lhr-solar/Controls-LightingPCB/README.md

# Controls-LightingPCB

Purpose: This board controls all lightings effects activated by driver controls on the inside and outside of the car.

Dimensions: 73.9140 mm by 98.8060 mm

BOM: Located under Controls-LightingPCB\BOM
