lhr-solar/Controls-LightingPCB/(threads)

Thread 6 (2021-11-02):

Change isoSPI -> SPI

HannahSLee14, 2021-11-02:
Since isoSPI is giving us a lot of issues, we are going to remove the chips associated with isoSPI (LTC6820 and HX1188FNL) and any components that are a part of its circuitry. We are going to send out the SPI signals instead (MISO, MOSI, CLK, CS).

** We should check the number of wires we can have in the steering wheel disconnect. **

Closed 2025-09-18.

Thread 7 (2021-11-20):

Remove Rearview Display Connector

JimothyGreene, 2021-11-20:
We're no longer routing 12V/GNDPWR through this board, so we can remove that connector

Closed 2025-09-18.

Thread 10 (2022-05-11):

Route the BPS fault ground trace to the BPS power LED as well.

babusid, 2022-05-11:
The BPS Power LED is currently hooked up to the wrong ground (ie. common ground plane), when it is not receiving the common 5v voltage that the rest of the LED use. It is receiving the 12v from the leaderboard which corresponds to the BPS Fault LED Ground.

Closed 2025-09-18.

Thread 12 (2023-02-25):

Missing gate pulldown resistor

tiandahuang, 2023-02-25:
missing gate pulldown resistor brakelight

Closed 2023-08-23.
