lhr-solar/Controls-LightingPCB/hardware/Controls-LightingRev2PCB.kicad_pcb

## KiCad design hardware/Controls-LightingRev2PCB.kicad_pcb (2026-03-15)

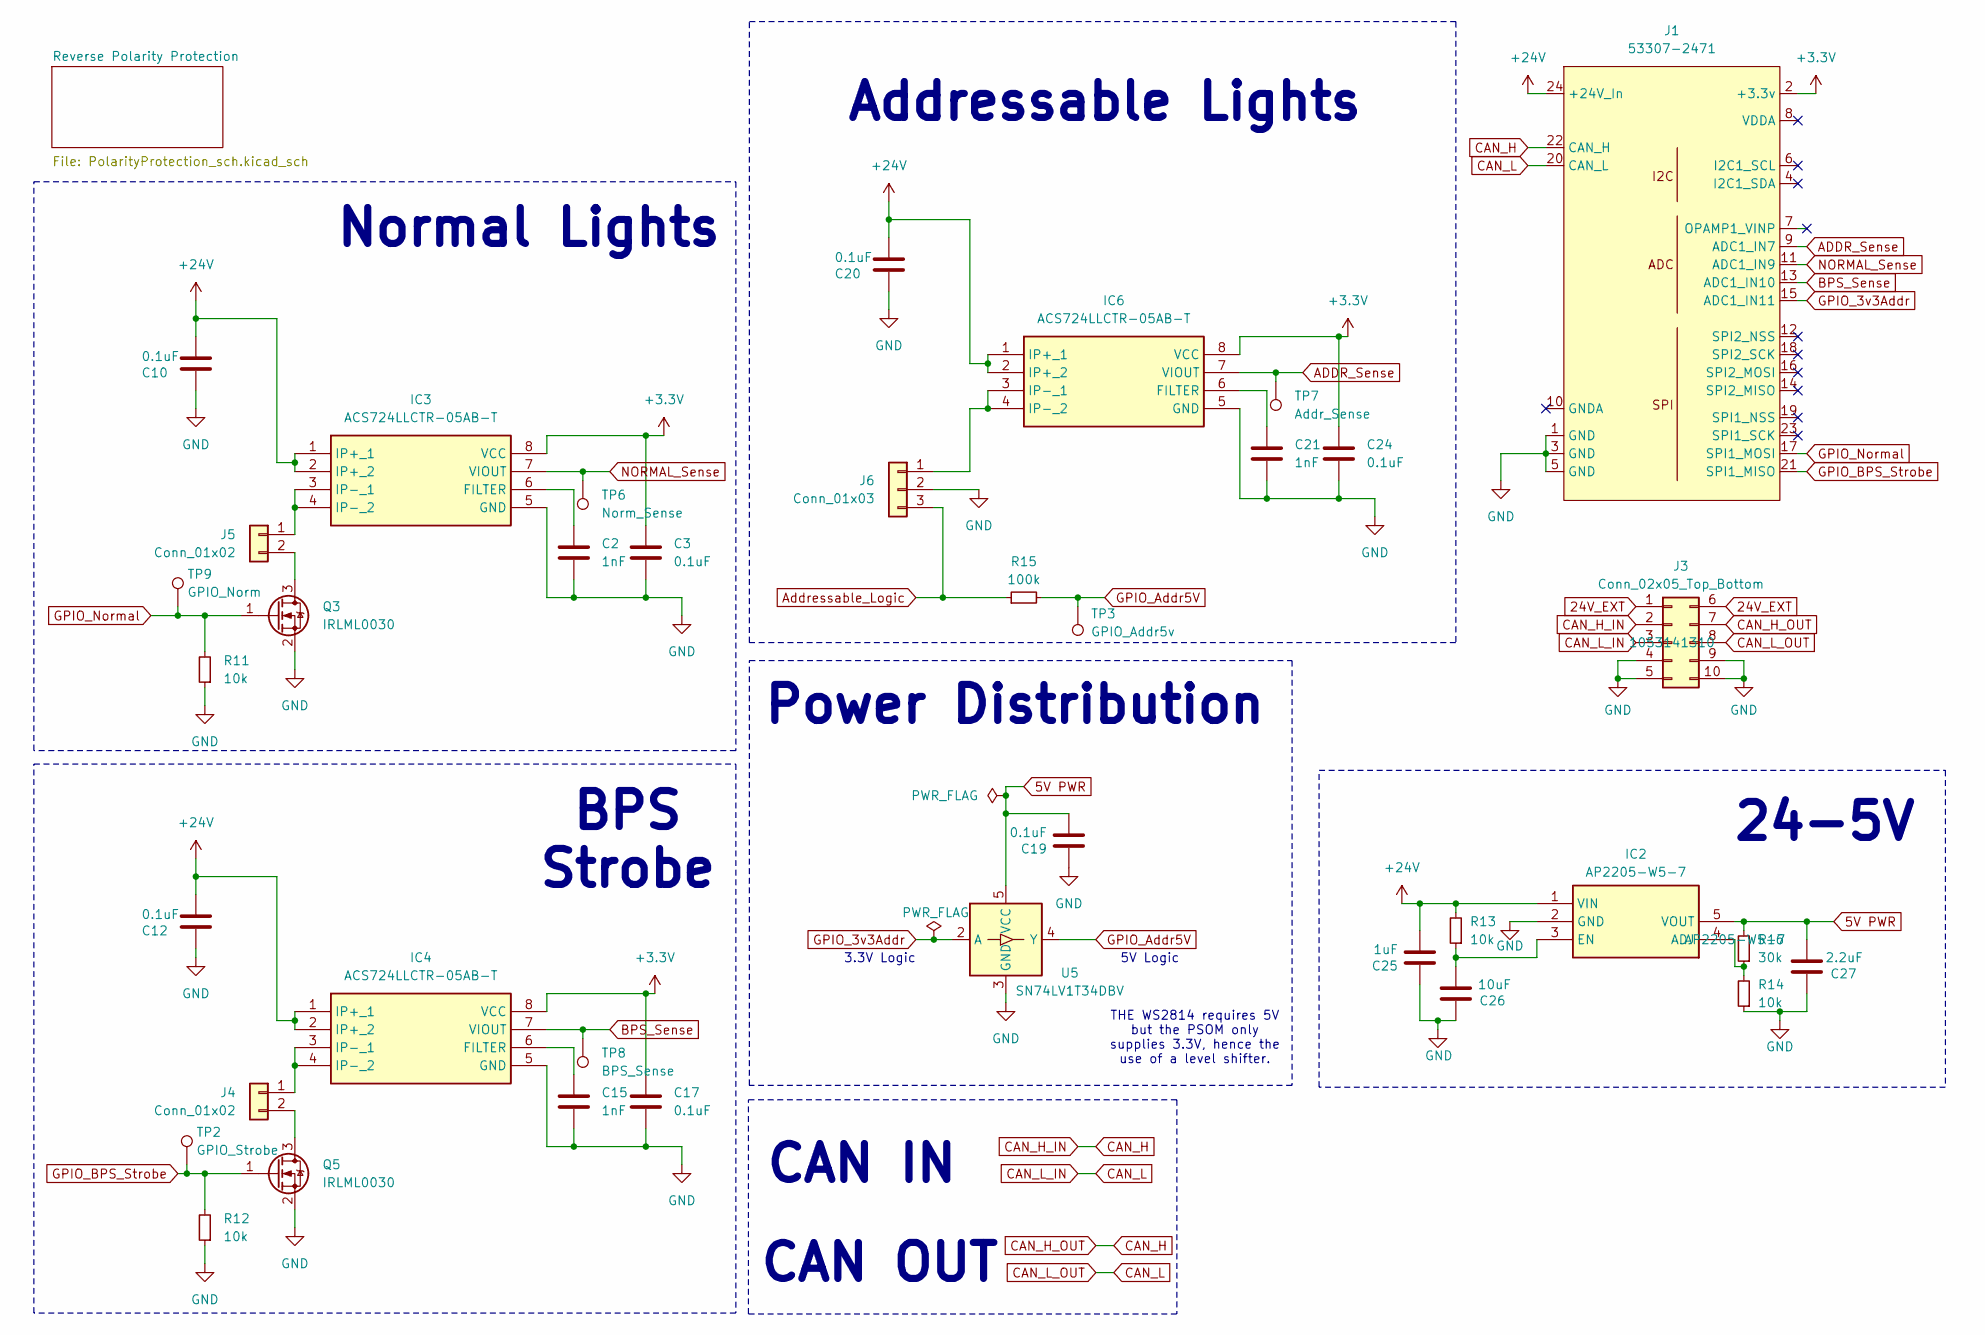
[picture p1: schematic Controls-LightingRev2PCB.kicad_sch]

Parts:
C2, C15, C21: 1nF; C_0603_1608Metric; LCSC P/N C1588
C3, C10, C12, C17, C19, C20, C24: 0.1uF; C_0603_1608Metric; LCSC P/N C14663
C25: 1uF; C_0603_1608Metric; LCSC P/N C15849
C26: 10uF; C_0805_2012Metric_Pad1.18x1.45mm_HandSolder; LCSC P/N C440198
C27: 2.2uF; C_0603_1608Metric; LCSC P/N C57895
IC2: AP2205-W5-7; AP2205W57; Mouser Part Number 621-AP2205-W5-7
IC3: ACS724LLCTR-05AB-T; SOIC127P600X175-8N; LCSC P/N C22392329
IC4: ACS724LLCTR-05AB-T; SOIC127P600X175-8N; Manufacturer_Part_Number ACS724LLCTR-05AB-T; LCSC P/N C22392329
IC6: ACS724LLCTR-05AB-T; SOIC127P600X175-8N; Mouser Part Number ACS724LLCTR-05AB-T
J1: 53307-2471; PeripheralSOM
J3: Conn_02x05_Top_Bottom; Molex_Nano-Fit_105314-xx10_2x05_P2.50mm_Horizontal
J4, J5: Conn_01x02; 105313-2102
J6: Conn_01x03; 105313-1103
Q3, Q5: IRLML0030; SOT-23; LCSC P/N C67272
R11, R12, R13, R14: 10k; R_0603_1608Metric; LCSC P/N C25804
R15: 100k; R_0603_1608Metric; LCSC P/N C25803
R16: 30k; R_0603_1608Metric; LCSC P/N C18681
TP2: GPIO_Strobe; TestPoint_Keystone_5005-5009_Compact
TP3: GPIO_Addr5v; TestPoint_Keystone_5005-5009_Compact
TP6: Norm_Sense; TestPoint_Keystone_5005-5009_Compact
TP7: Addr_Sense; TestPoint_Keystone_5005-5009_Compact
TP8: BPS_Sense; TestPoint_Keystone_5005-5009_Compact
TP9: GPIO_Norm; TestPoint_Keystone_5005-5009_Compact
U5: SN74LV1T34DBV; SOT-23-5; LCSC P/N C47117565

Connections:
5V PWR: C19.2, C27.2, IC2.5 (VOUT), R16.2, U5.5 (VCC)
24V_EXT: J3.1, J3.6; also elsewhere on the board
+3.3V: C3.1, C17.1, C24.1, IC3.8 (VCC), IC4.8 (VCC), IC6.8 (VCC), J1.2 (+3.3v)
+24V: C10.2, C12.2, C20.2, C25.2, IC2.1 (VIN), IC3.1 (IP+_1), IC3.2 (IP+_2), IC4.1 (IP+_1), IC4.2 (IP+_2), IC6.1 (IP+_1), IC6.2 (IP+_2), J1.24 (+24V_In), R13.2; also elsewhere on the board
ADDR_Sense: IC6.7 (VIOUT), J1.9 (ADC1_IN7), TP7.1
Addressable_Logic: J6.3, R15.1
BPS_Sense: IC4.7 (VIOUT), J1.13 (ADC1_IN10), TP8.1
CAN_H: J1.22 (CAN_H), J3.2, J3.7
CAN_L: J1.20 (CAN_L), J3.3, J3.8
GND: C2.2, C3.2, C10.1, C12.1, C15.2, C17.2, C19.1, C20.1, C21.2, C24.2, C25.1, C26.1, C27.1, IC2.2 (GND), IC3.5 (GND), IC4.5 (GND), IC6.5 (GND), J1.1 (GND), J1.3 (GND), J1.5 (GND), J3.4, J3.5, J3.9, J3.10, J6.2, Q3.2 (S), Q5.2 (S), R11.1, R12.1, R14.1, U5.3 (GND); also elsewhere on the board
GPIO_3v3Addr: J1.15 (ADC1_IN11), U5.2 (A)
GPIO_Addr5V: R15.2, TP3.1, U5.4 (Y)
GPIO_BPS_Strobe: J1.21 (SPI1_MISO), Q5.1 (G), R12.2, TP2.1
GPIO_Normal: J1.17 (SPI1_MOSI), Q3.1 (G), R11.2, TP9.1
NORMAL_Sense: IC3.7 (VIOUT), J1.11 (ADC1_IN9), TP6.1
unnamed: IC2.4 (ADJ), R14.2, R16.1
unnamed: C26.2, IC2.3 (EN), R13.1
unnamed: C2.1, IC3.6 (FILTER)
unnamed: IC3.3 (IP-_1), IC3.4 (IP-_2), J5.1
unnamed: C15.1, IC4.6 (FILTER)
unnamed: IC4.3 (IP-_1), IC4.4 (IP-_2), J4.1
unnamed: C21.1, IC6.6 (FILTER)
unnamed: IC6.3 (IP-_1), IC6.4 (IP-_2), J6.1
unnamed: J4.2, Q5.3 (D)
unnamed: J5.2, Q3.3 (D)

Notes on the sheet:
CAN IN
CAN OUT
THE WS2814 requires 5V but the PSOM only supplies 3.3V, hence the use of a level shifter.
24-5V
5V Logic
3.3V Logic
Normal Lights
Addressable Lights
Power Distribution
BPS Strobe

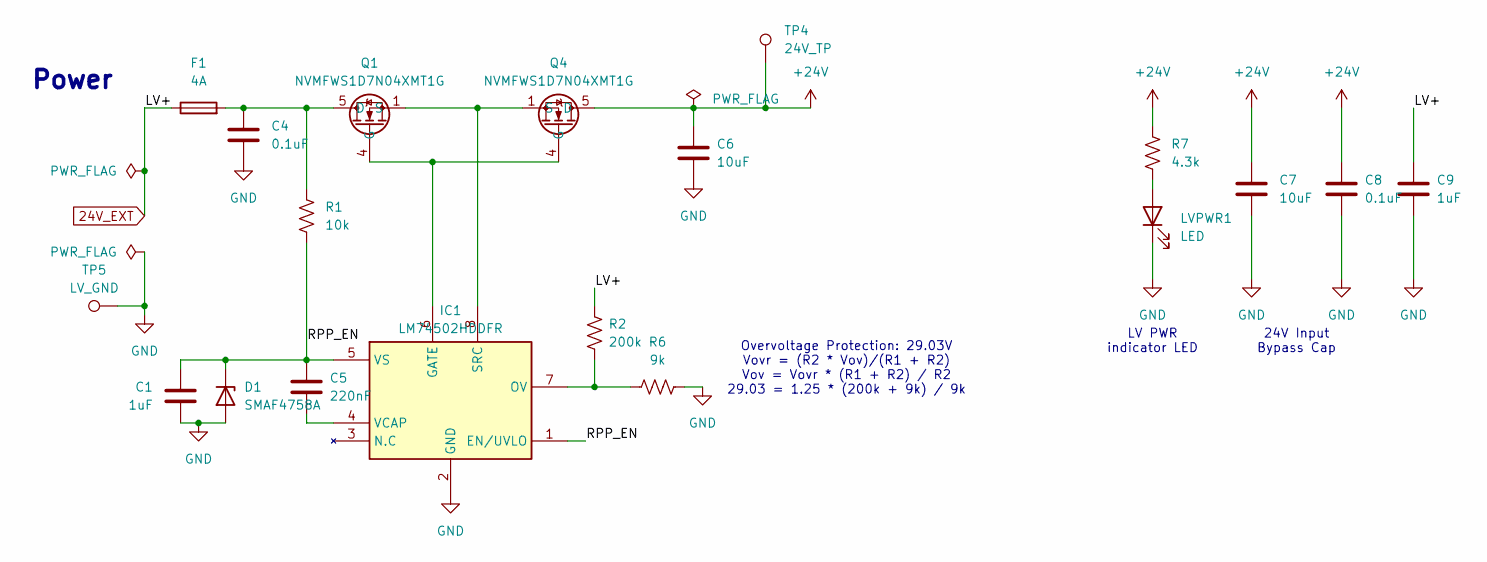
[picture p2: schematic PolarityProtection_sch.kicad_sch]

Parts:
C1: 1uF; C_0603_1608Metric; Mouser Part Number 963-UMK107BJ105KA-T
C4, C8: 0.1uF; C_0603_1608Metric; Mouser Part Number 963-HMK107B7104KA-T
C5: 220nF; C_0603_1608Metric; Mouser Part Number 963-MSASU168SB7224KT
C6, C7: 10uF; C_0805_2012Metric_Pad1.18x1.45mm_HandSolder; Mouser Part Number 81-GRM21BR61H106KE3K
C9: 1uF; C_0603_1608Metric; Mouser Part Number 963-HMK107B7104KA-T
D1: SMAF4758A; SODFL5026X125N
F1: 4A; FUSE_3568; Mouser P/N 534-3568
IC1: LM74502HDDFR; SOT65P280X110-8N; Mouser Part Number 595-LM74502HDDFR
LVPWR1: LED; LED_0603_1608Metric_Pad1.05x0.95mm_HandSolder; LCSC P/N C7371904
Q1, Q4: NVMFWS1D7N04XMT1G; NVMFWS3D0P04M8LT1G; LCSC P/N C133142
R1: 10k; R_0603_1608Metric; Mouser Part Number 71-CRCW060310K0FKEI
R2: 200k; R_0603_1608Metric; Mouser Part Number 594-MCT06030C2003FP5
R6: 9k; R_0603_1608Metric; Mouser Part Number 594-MCT06030C9091FP5
R7: 4.3k; R_0603_1608Metric; Mouser Part Number 71-CRCW0603-4.3K-E3
TP4: 24V_TP; TestPoint_Keystone_5005-5009_Compact
TP5: LV_GND; TestPoint_Keystone_5005-5009_Compact

Connections:
24V_EXT: C9.1, F1.1, R2.1; also elsewhere on the board
+24V: C6.1, C7.1, C8.1, Q4.5 (D), Q4.6 (D), Q4.7 (D), Q4.8 (D), Q4.9 (D), R7.1, TP4.1; also elsewhere on the board
/Reverse Polarity Protection/RPP_EN: C1.2, C5.1, D1.1 (K), IC1.1 (EN/UVLO), IC1.5 (VS), R1.2
GND: C1.1, C4.2, C6.2, C7.2, C8.2, C9.2, D1.2 (A), IC1.2 (GND), LVPWR1.1 (K), R6.2, TP5.1; also elsewhere on the board
unnamed: C4.1, F1.2, Q1.5 (D), Q1.6 (D), Q1.7 (D), Q1.8 (D), Q1.9 (D), R1.1
unnamed: IC1.6 (GATE), Q1.4 (G), Q4.4 (G)
unnamed: IC1.7 (OV), R2.2, R6.1
unnamed: IC1.8 (SRC), Q1.1 (S), Q1.2 (S), Q1.3 (S), Q4.1 (S), Q4.2 (S), Q4.3 (S)
unnamed: C5.2, IC1.4 (VCAP)
unnamed: LVPWR1.2 (A), R7.2

Notes on the sheet:
Overvoltage Protection: 29.03V Vovr = (R2 * Vov)/(R1 + R2) Vov = Vovr * (R1 + R2) / R2 29.03 = 1.25 * (200k + 9k) / 9k
24V Input Bypass Cap
LV PWR indicator LED
Power

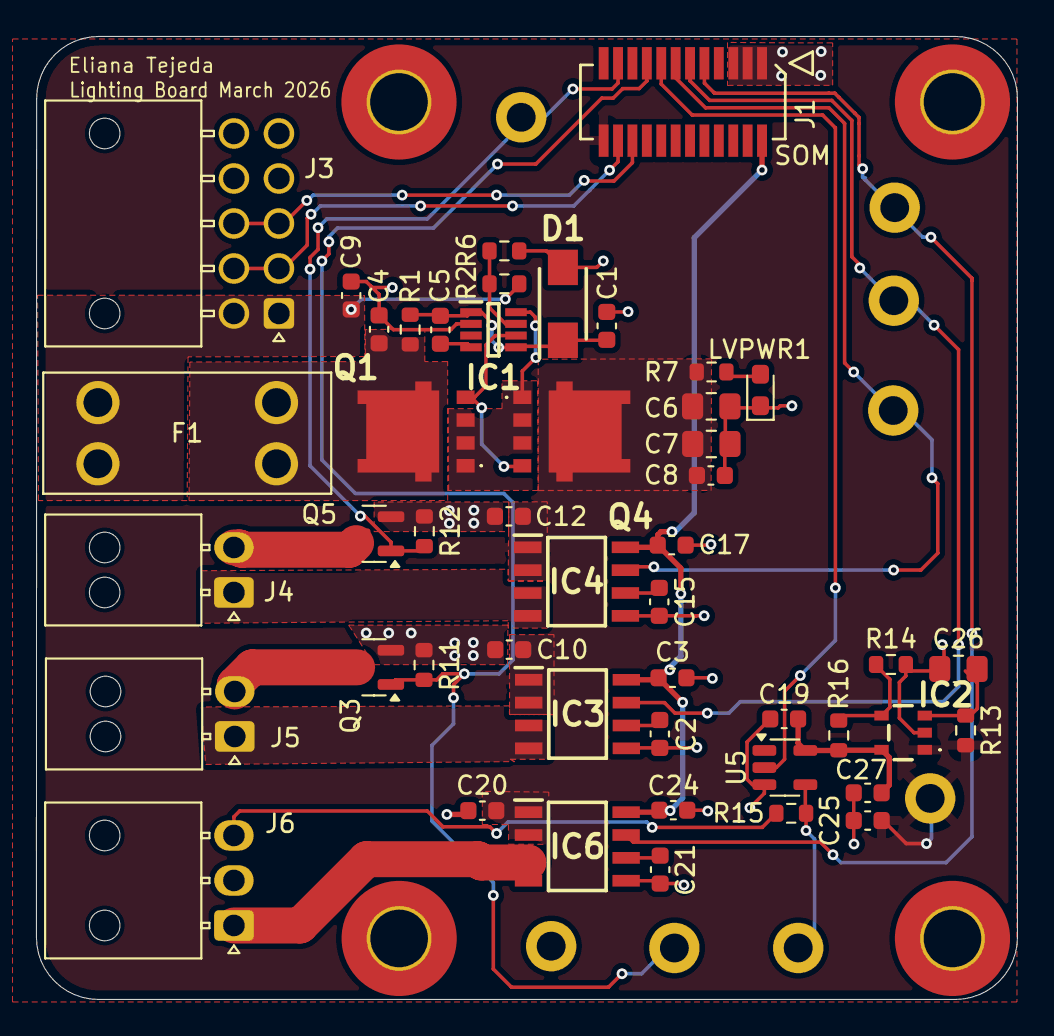
[picture p3: board Controls-LightingRev2PCB.kicad_pcb from above]

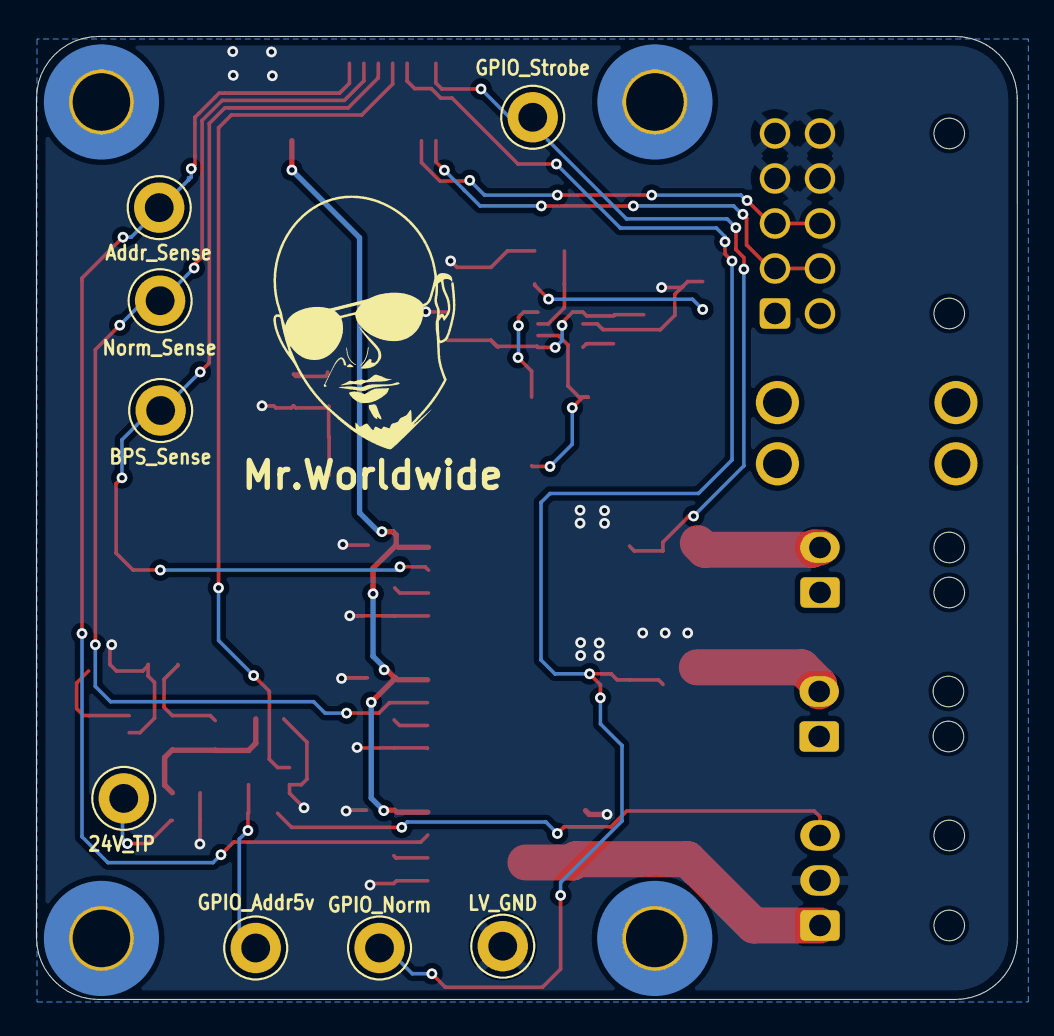
[picture p4: board Controls-LightingRev2PCB.kicad_pcb from below]

Board: 2 copper layers, 54.5 x 53.5 mm, 57 parts (9 on the bottom side), 32 nets.

Other parts of the board:
Mr.Worldwide: LOGO
