lhr-solar/Controls-LightingPCB/Firmware/LB.ioc

Mcu.UserName=STM32L431CBTx
PA0.Signal=OPAMP1_VINP
PA1.Signal=OPAMP1_VINM
PA10.Signal=USART1_RX
PA11.Signal=SPI1_MISO
PA12.Signal=SPI1_MOSI
PA2.Signal=ADCx_IN7
PA3.Signal=OPAMP1_VOUT
PA4.Signal=ADCx_IN9
PA5.Signal=ADCx_IN10
PA6.Signal=S_TIM16_CH1
PA7.Signal=GPIO_Output
PA8.Signal=GPIO_Output
PA9.Signal=USART1_TX
PB0.Signal=SPI1_NSS
PB1.Signal=ADCx_IN16
PB10.Signal=SPI2_SCK
PB11.Signal=GPIO_Output
PB12.Signal=SPI2_NSS
PB14.Signal=SPI2_MISO
PB15.Signal=SPI2_MOSI
PB6.Signal=I2C1_SCL
PB7.Signal=I2C1_SDA
PB8.Signal=CAN1_RX
PB9.Signal=CAN1_TX
