lhr-solar/Controls-LightingPCB/(commit log)

2020-09-19 Added UTSVT KiCad Libraries
2020-09-26 Started working on PCB layout
    [Controls-LightingPCB.kicad_pcb, Controls-LightingPCB.sch]
2020-09-26 Finished PCB layout
    [Controls-LightingPCB.kicad_pcb, Controls-LightingPCB.sch]
2020-10-03 Adds hierarchical sheets for control switches and switch register
    [ControlSwitches.sch, ShiftReg.sch]
2020-10-03 Creates hierarchical sheets
    [ControlSwitches.sch, Controls-LightingPCB.sch, ShiftReg.sch]
2020-10-03 Added hierarchical sheets and connections
    [ControlLEDs.sch, ControlSwitches.sch, Controls-LightingPCB.sch, ShiftReg.sch]
2020-10-03 Added HX1188FNL
    [ControlLEDs.sch, ControlSwitches.sch, Controls-LightingPCB.sch, ShiftReg.sch]
2020-10-03 Added LTC6820
    [Controls-LightingPCB.sch]
2020-10-03 Edited cap and res values
    [Controls-LightingPCB.sch]
2020-10-09 Started working on PCD design, preliminary layout of components
    [ControlLEDs.sch, ControlSwitches.sch, Controls-LightingPCB.kicad_pcb, Controls-LightingPCB.sch, ShiftReg.sch]
2020-10-10 Moves files out of individual folder and updates library paths
    [ControlLEDs.sch, ControlSwitches.sch, Controls-LightingPCB.kicad_pcb, Controls-LightingPCB.sch, ShiftReg.sch]
2020-10-10 Added changes to PCB Design
    [Controls-LightingPCB.kicad_pcb]
2020-10-10 Updated board component labels
    [Controls-LightingPCB.kicad_pcb]
2020-10-17 Switched LEDs to back side and changed dimensions of board
    [Controls-LightingPCB.kicad_pcb, Controls-LightingPCB.sch]
2020-10-17 Tried to start layout of the back side
    [Controls-LightingPCB.kicad_pcb]
2020-10-17 Made connections on back of the board
    [Controls-LightingPCB.kicad_pcb]
2020-10-17 Finished vias. Isolated U2 from GND and GNDPWR.
    [Controls-LightingPCB.kicad_pcb]
2020-10-18 Redid some connections.
    [Controls-LightingPCB.kicad_pcb]
2020-10-24 Added switch labels and got through most of checklist
    [Controls-LightingPCB.kicad_pcb]
2020-10-24 Added mounting holes and adjusted design accordingly
    [Controls-LightingPCB.sch]
2020-10-24 Fixed switch labels
    [Controls-LightingPCB.kicad_pcb]
2020-10-31 Deleted TODO in Switches
    [ControlSwitches.sch]
2020-11-14 Minor changes
    [ControlLEDs.sch, ControlSwitches.sch, Controls-LightingPCB.kicad_pcb, Controls-LightingPCB.sch, PowerDist.sch, ShiftReg.sch]
2020-11-14 Changed orientation and dimensions of board.
    [Controls-LightingPCB.kicad_pcb]
2020-11-14 Resized PCB, changed switches to horizontal, need to organize components
    [ControlSwitches.sch, Controls-LightingPCB.kicad_pcb]
2020-11-21 Changed all switch connectors to horizontal, board dimensions to 2.5in by 4.5in, and started board layout
    [ControlSwitches.sch, Controls-LightingPCB.kicad_pcb, Controls-LightingPCB.sch]
2020-11-21 Added Regen switch, deleted RSVD LED
    [ControlLEDs.sch, ControlSwitches.sch, Controls-LightingPCB.sch, ShiftReg.sch]
2020-11-22 Started placing routes, did not finish
    [ControlSwitches.sch, Controls-LightingPCB.kicad_pcb, Controls-LightingPCB.sch, ShiftReg.sch]
2020-12-02 Added several tracks, fixed exclusion zone
    [Controls-LightingPCB.kicad_pcb]
2020-12-03 Finished connections and changed F/W switch, but hierarchial labels on schematic need to be fixed
    [ControlSwitches.sch, Controls-LightingPCB.kicad_pcb, Controls-LightingPCB.sch]
2020-12-04 Updated schematic with changed F/W switch and BPS_PWR direct connection to MinionConn
    [ControlSwitches.sch, Controls-LightingPCB.sch, ShiftReg.sch]
2020-12-04 Changed minion conn
    [Controls-LightingPCB.kicad_pcb]
2020-12-04 Finished current updates to the board
    [ControlSwitches.sch, Controls-LightingPCB.kicad_pcb, Controls-LightingPCB.sch, ShiftReg.sch]
2020-12-04 Changed Shift Regsiter labels to GPIO Expander
    [Controls-LightingPCB.kicad_pcb, Controls-LightingPCB.sch, GPIOExpander.sch]
2020-12-05 Fixing merge issues
    [Controls-LightingPCB.sch, PowerDist.sch]
2020-12-05 Fixed BPS_PWR lines
    [ControlLEDs.sch, Controls-LightingPCB.kicad_pcb, Controls-LightingPCB.sch]
2020-12-19 Changed Schematic, but not PCB layout. Updated LED resistor values
    [ControlLEDs.sch, ControlSwitches.sch, Controls-LightingPCB.sch, PowerDist.sch]
2020-12-19 Reformatted PCB layout with schematic changes
    [Controls-LightingPCB.kicad_pcb, Controls-LightingPCB.sch]
2020-12-19 Changed switches
    [ControlSwitches.sch]
2020-12-19 Board finished with the new changes, needs to be checked
    [ControlLEDs.sch, ControlSwitches.sch, Controls-LightingPCB.kicad_pcb, Controls-LightingPCB.sch]
2020-12-20 Fixes switch/button circuitry
    [ControlSwitches.sch, Controls-LightingPCB.kicad_pcb, Controls-LightingPCB.sch]
2021-01-10 Adds gerbers
    [Controls-LightingPCB-B_Cu.gbr, Controls-LightingPCB-B_Mask.gbr, Controls-LightingPCB-B_Paste.gbr, Controls-LightingPCB-B_SilkS.gbr, Controls-LightingPCB-Edge_Cuts.gbr, Controls-LightingPCB-F_Cu.gbr, Controls-LightingPCB-F_Mask.gbr, Controls-LightingPCB-F_Paste.gbr]
2021-10-02 Added resistor and diode
    [Controls-LightingPCB.kicad_pcb, Controls-LightingPCB.sch, PowerDist.sch]
2021-10-03 Extends keepout zone
    [Controls-LightingPCB.kicad_pcb]
2021-10-03 Remove some ground plane underneath isoSPI signals
    [Controls-LightingPCB.kicad_pcb]
2021-10-04 Updates gerbers and version number
    [Controls-LightingPCB-B_Cu.gbr, Controls-LightingPCB-B_Mask.gbr, Controls-LightingPCB-B_Paste.gbr, Controls-LightingPCB-B_SilkS.gbr, Controls-LightingPCB-Edge_Cuts.gbr, Controls-LightingPCB-F_Cu.gbr, Controls-LightingPCB-F_Mask.gbr, Controls-LightingPCB-F_Paste.gbr]
2021-10-30 Adds the gerbers
    [Controls-LightingPCB-B_Cu.gbr, Controls-LightingPCB-B_Mask.gbr, Controls-LightingPCB-B_Paste.gbr, Controls-LightingPCB-B_SilkS.gbr, Controls-LightingPCB-Edge_Cuts.gbr, Controls-LightingPCB-F_Cu.gbr, Controls-LightingPCB-F_Mask.gbr, Controls-LightingPCB-F_Paste.gbr]
2021-10-30 Footprint edit
    [Controls-LightingPCB.kicad_pcb, Controls-LightingPCB.sch]
2021-11-13 isoSPI -> SPI change
    [Controls-LightingPCB.kicad_pcb, Controls-LightingPCB.sch, PowerDist.sch]
2021-11-13 isoSPI -> SPI 2
    [ControlLEDs.sch, ControlSwitches.sch, Controls-LightingPCB.sch, PowerDist.sch]
2021-11-20 Deleted backup camera
    [ControlSwitches.sch, Controls-LightingPCB.kicad_pcb, Controls-LightingPCB.sch, PowerDist.sch]
2021-11-21 makes changes to traces(11/20/21)
    [Controls-LightingPCB.kicad_pcb]
2021-11-21 Reviews layout
    [Controls-LightingPCB.kicad_pcb]
2021-12-07 Adds gerbers and finalizes the new version
    [Controls-LightingPCB-B_Cu.gbr, Controls-LightingPCB-B_Mask.gbr, Controls-LightingPCB-B_Paste.gbr, Controls-LightingPCB-B_SilkS.gbr, Controls-LightingPCB-Edge_Cuts.gbr, Controls-LightingPCB-F_Cu.gbr, Controls-LightingPCB-F_Mask.gbr, Controls-LightingPCB-F_Paste.gbr]
2022-05-01 Fix issue with LED
    [ControlLEDs.kicad_sch, ControlLEDs.sch, ControlSwitches.kicad_sch, ControlSwitches.sch, Controls-LightingPCB.kicad_pcb, Controls-LightingPCB.kicad_sch, Controls-LightingPCB.sch, PowerDist.kicad_sch]
2022-05-21 Adds 60ohm resistor to MISO line
    [ControlLEDs.kicad_sch, Controls-LightingPCB.kicad_pcb, Controls-LightingPCB.kicad_sch]
2022-08-19 added clk circuit, began removing unnecessary nets and pins
    [BlinkTimer.kicad_sch]
2022-08-21 finished schematic rev1
    [BlinkTimer.kicad_sch, ControlLEDs.kicad_sch, ControlSwitches.kicad_sch, Controls-LightingPCB.kicad_pcb, Controls-LightingPCB.kicad_sch, PowerDist.kicad_sch]
2022-08-27 redo schematic
    [BlinkTimer.kicad_sch, ControlSwitches.kicad_sch, Controls-LightingPCB.kicad_pcb, Controls-LightingPCB.kicad_sch]
2022-08-30 added todo
    [BlinkTimer.kicad_sch, ControlSwitches.kicad_sch, Controls-LightingPCB.kicad_sch]
2022-09-01 added comments
    [ControlSwitches.kicad_sch, Controls-LightingPCB.kicad_sch]
2022-09-02 added brakelight
    [Controls-LightingPCB.kicad_sch]
2022-09-08 added capacitors to the switches, no-pop resistors to the light ports, added ports for internal indicator lights
    [ControlSwitches.kicad_sch, Controls-LightingPCB.kicad_sch]
2022-09-10 Added low side mosfet, small fixes to timer circuit
    [Controls-LightingPCB.kicad_sch]
2022-09-10 changed to low-side mosfet switching on IC after switching IC to +5v instead of +12v.
    [Controls-LightingPCB.kicad_sch]
2022-09-12 added pull-downs for mosfets, fixed mosfet orientation, added real diodes
    [Controls-LightingPCB.kicad_sch]
2022-09-12 Added a few questions and comments for design review
    [Controls-LightingPCB.kicad_sch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]
2022-09-12 fixed diode protection
    [Controls-LightingPCB.kicad_sch]
2022-09-17 finished adding backup ports for gear selector and SW lights
    [Controls-LightingPCB.kicad_sch]
2022-09-17 reverted to buttons for cruise control
    [Controls-LightingPCB.kicad_sch]
2022-09-28 PCB layout #1
    [Controls-LightingPCB.kicad_pcb, Controls-LightingPCB.kicad_sch]
2022-10-03 is square now
    [Controls-LightingPCB.kicad_pcb]
2022-10-15 Component layout
    [Controls-LightingPCB.kicad_pcb]
2022-10-15 Pico-Claps connectors + traces
    [Controls-LightingPCB.kicad_pcb, Controls-LightingPCB.kicad_sch]
2022-10-22 Changes to traces/silkscreens
    [Controls-LightingPCB.kicad_pcb]
2022-10-22 edge cuts
    [Controls-LightingPCB.kicad_pcb]
2022-11-05 moved components to front, fixed traces/planes
    [Controls-LightingPCB.kicad_pcb]
2022-11-05 Changed to SMD mosfets
    [Controls-LightingPCB.kicad_pcb, Controls-LightingPCB.kicad_sch]
2022-11-12 updated board
    [Controls-LightingPCB.kicad_pcb]
2022-11-12 changes to traces and movement of test points
    [Controls-LightingPCB.kicad_pcb]
2022-11-19 dimensions but like fr this time
    [Controls-LightingPCB.kicad_pcb]
2022-12-03 Changes to track/via sizes
    [Controls-LightingPCB.kicad_pcb]
2022-12-03 Changes to planes
    [Controls-LightingPCB.kicad_pcb]
2022-12-10 First bad layout
    [Controls-LightingPCB.kicad_pcb, Controls-LightingPCB.kicad_sch]
2022-12-10 finished layout
    [Controls-LightingPCB.kicad_pcb, Controls-LightingPCB.kicad_sch]
2022-12-10 Added more stitching vias on edges of board
    [Controls-LightingPCB.kicad_pcb]
2022-12-12 moved traces away from tht connectors
    [Controls-LightingPCB.kicad_pcb]
2023-01-06 Created Gerber and Drill Files
    [Controls-LightingPCB-B_Cu.gbr, Controls-LightingPCB-B_Mask.gbr, Controls-LightingPCB-B_Paste.gbr, Controls-LightingPCB-B_Silkscreen.gbr, Controls-LightingPCB-Edge_Cuts.gbr, Controls-LightingPCB-F_Cu.gbr, Controls-LightingPCB-F_Mask.gbr, Controls-LightingPCB-F_Paste.gbr]
2023-01-21 component updates
    [Controls-LightingPCB.kicad_sch]
2023-01-27 fixed timer
    [Controls-LightingPCB.kicad_pcb, Controls-LightingPCB.kicad_sch]
2023-01-28 Change schematics
    [Controls-LightingPCB.kicad_pcb, Controls-LightingPCB.kicad_sch]
2023-01-29 schematic fixes and minor changes. no major part changes
    [Controls-LightingPCB.kicad_sch]
2023-01-29 replace and reroute
    [Controls-LightingPCB.kicad_pcb, Controls-LightingPCB.kicad_sch]
2023-01-29 review changes
    [Controls-LightingPCB.kicad_pcb, Controls-LightingPCB.kicad_sch]
2023-01-30 strategic bombing
    [Controls-LightingPCB.kicad_sch, Controls-LightingPCB.xlsx]
2023-05-22 Made several QAC changes as per new attempt to standardize PCB Design
    [Controls-LightingPCB-B_Cu.gbr, Controls-LightingPCB-B_Mask.gbr, Controls-LightingPCB-B_Paste.gbr, Controls-LightingPCB-B_Silkscreen.gbr, Controls-LightingPCB-Edge_Cuts.gbr, Controls-LightingPCB-F_Cu.gbr, Controls-LightingPCB-F_Mask.gbr, Controls-LightingPCB-F_Paste.gbr]
2023-06-13 Added Opto-Isolators to Minion Connector interfacing
    [Controls-LightingPCB.kicad_sch]
2023-06-13 Added secondary schematic for Minion Connector
    [MinionConn.kicad_sch]
2023-06-19 Fixed Submodule and started Standardizing
    [Controls-LightingPCB.kicad_sch]
2023-06-19 Finished Schematic
    [Controls-LightingPCB.kicad_sch, MinionConn.kicad_sch]
2023-08-07 Opto-Isolators now interface mosfets to avoid ground problems, also separated 12V 'power' ground and ground passed from minion connector
    [Controls-LightingPCB.kicad_sch, MinionConn.kicad_sch]
2023-08-23 Did layout
    [Controls-LightingPCB.kicad_pcb, Controls-LightingPCB.kicad_sch, Inputs.kicad_sch, Lights.kicad_sch, MinionConn.kicad_sch, PowerDistribution.kicad_sch]
2023-08-23 Fixed plane and created gerbers
    [Controls-LightingPCB-B_Cu.gbr, Controls-LightingPCB-B_Mask.gbr, Controls-LightingPCB-B_Paste.gbr, Controls-LightingPCB-B_Silkscreen.gbr, Controls-LightingPCB-Edge_Cuts.gbr, Controls-LightingPCB-F_Cu.gbr, Controls-LightingPCB-F_Mask.gbr, Controls-LightingPCB-F_Paste.gbr]
2023-08-26 Updated html bom
2023-09-25 Updated gerbers zip
2023-10-10 Added BOM
    [Controls-LightingPCB.kicad_sch, Controls-LightingPCB.xlsx, Inputs.kicad_sch, Lights.kicad_sch, MinionConn.kicad_sch, PowerDistribution.kicad_sch]
2023-10-10 Converted to excel sheet
    [Controls-LightingPCB.xlsx]
2025-08-31 Initial Schematic
    Lighting Board Initial Schematic.
    [Controls-LightingRev2PCB.kicad_pcb, Controls-LightingRev2PCB.kicad_sch, Inputs.kicad_sch, Lights.kicad_sch, MinionConn.kicad_sch, Normal_Lights.kicad_sch, Notes.kicad_sch, PWR.kicad_sch]
2025-09-04 cleaned up repo
    [Controls-LightingPCB.kicad_pcb, Controls-LightingPCB.kicad_sch, Controls-LightingPCB.xlsx, Controls-LightingRev2PCB.kicad_sch, Inputs.kicad_sch, Lights.kicad_sch, MinionConn.kicad_sch, Normal_Lights.kicad_sch]
2025-09-05 Need 24V to 5V from PSOM PCB
    [Controls-LightingRev2PCB.kicad_sch]
2025-09-05 Need 24 to 5V from PSOM
    [Controls-LightingRev2PCB.kicad_pcb, Controls-LightingRev2PCB.kicad_sch]
2025-09-05 Remove old files
    [Controls-LightingRev2PCB.kicad_pcb]
2025-09-12 Added reverse polarity, 5v buck, assigned shunt and feedback resistor values, and GPIO pins
    [Buck_Converter_sch.kicad_sch, Controls-LightingRev2PCB.kicad_sch, PowerDistribution_sch.kicad_sch, ReversePolarityProtection_sch.kicad_sch]
2025-09-16 Switched to a current sensing IC and assigned a new shunt value according to a fixed gain of 200.
    [Buck_Converter_sch.kicad_sch, Controls-LightingRev2PCB.kicad_sch]
2025-09-19 Initial Schematic Review for addressble lights, normal lights, and BPS strobe.
    [Buck_Converter_sch.kicad_sch, Controls-LightingRev2PCB.kicad_sch, PolarityProtection_sch.kicad_sch, Power_Distribution_sch.kicad_sch]
2025-09-24 Add shared KiCad libraries and update .gitmodules
    [75757-4160.SchLib, 75757-4160.stp, 757574160.PcbLib, 757574160.psm, Buck_Converter_sch.kicad_sch, Controls-LightingRev2PCB.kicad_sch, EDI2CAP.CFG, PolarityProtection_sch.kicad_sch]
2025-09-24 Removed old schematic files
    [Buck_Converter_sch.kicad_sch, PolarityProtection_sch.kicad_sch, PowerDistribution_sch.kicad_sch, Power_Distribution_sch.kicad_sch, ReversePolarityProtection_sch.kicad_sch]
2025-09-24 Added 16 pin connector, fuse, and BPS strobe circuit.
    [PolarityProtection_sch.kicad_sch]
2025-09-27 Review BPS strobe, additional fuse, and buck.
    [PolarityProtection_sch.kicad_sch]
2025-09-27 Hopefully last schematic review
    [0759001181.stp, Controls-LightingRev2PCB.kicad_pcb, Controls-LightingRev2PCB.kicad_sch]
2025-10-08 New board dimensions
    [Controls-LightingRev2PCB.kicad_pcb]
2025-10-08 Clean submodule KiCAD-Sharepoint
2025-10-08 Componenent Layout, I branched into MX150_Connectors however, I can't seem to find the 2x8 connector. It's probably an issue on my end but I can look into it later
    [Controls-LightingRev2PCB.kicad_pcb]
2025-10-12 Routed but having issues with gnd being pretty isolated
    [Controls-LightingRev2PCB.kicad_pcb, Controls-LightingRev2PCB.kicad_sch, PolarityProtection_sch.kicad_sch]
2025-10-22 Test points added
    [Controls-LightingRev2PCB.kicad_pcb, Controls-LightingRev2PCB.kicad_sch]
2025-10-22 slight test point and keep out updates
    [Controls-LightingRev2PCB.kicad_pcb]
2025-10-22 rounded corners + gerbers
    [Controls-LightingRev2PCB.kicad_pcb]
2025-10-22 make source trace larger + fix minor clearance violations
    [Controls-LightingRev2PCB.kicad_pcb]
2025-10-22 regen gerber files
    [Controls-LightingPCB-B_Cu.gbr, Controls-LightingPCB-B_Mask.gbr, Controls-LightingPCB-B_Paste.gbr, Controls-LightingPCB-B_Silkscreen.gbr, Controls-LightingPCB-Edge_Cuts.gbr, Controls-LightingPCB-F_Cu.gbr, Controls-LightingPCB-F_Mask.gbr, Controls-LightingPCB-F_Paste.gbr]
2025-12-06 Remove unused files
    [0759001181.stp, 75757-4160.SchLib, 75757-4160.stp, 757574160.PcbLib, 757574160.psm]
2025-12-19 Rev B initial rework
    [Controls-LightingRev2PCB.kicad_pcb]
2025-12-23 Correct LDO
    [Controls-LightingRev2PCB.kicad_sch]
2026-01-05 Rev B schematic Review for correct SOM connector and new IC
    [ACS724LLCTR-05AU-T.SchLib, ACS724LLCTR-05AU-T.stp, Controls-LightingRev2PCB.kicad_pcb, Controls-LightingRev2PCB.kicad_sch, EDI2CAP.CFG, PolarityProtection_sch.kicad_sch, SOIC127P600X175-8N.PcbLib, chips.prt]
2026-01-05 Rev B schematic Review with new IC
    [Controls-LightingRev2PCB.kicad_sch, PolarityProtection_sch.kicad_sch]
2026-01-08 Switched MX150 to 02x05 nanofet
    [Controls-LightingRev2PCB.kicad_pcb, Controls-LightingRev2PCB.kicad_sch, PolarityProtection_sch.kicad_sch]
2026-01-08 Current Layout
    [Controls-LightingRev2PCB.kicad_pcb, Controls-LightingRev2PCB.kicad_sch, PolarityProtection_sch.kicad_sch]
2026-01-09 Layout 53.5
    [Controls-LightingRev2PCB.kicad_pcb]
2026-01-09 layout recommendations
    [Controls-LightingRev2PCB.kicad_pcb]
2026-01-09 Layout Review
    [Controls-LightingRev2PCB.kicad_pcb, Controls-LightingRev2PCB.kicad_sch, PolarityProtection_sch.kicad_sch]
2026-01-10 Some routing
    [Controls-LightingRev2PCB.kicad_pcb, Controls-LightingRev2PCB.kicad_sch, PolarityProtection_sch.kicad_sch]
2026-01-11 Ready for Layout Review
    [Controls-LightingRev2PCB.kicad_pcb]
2026-01-12 All review requests escept LDO addressed
    [Controls-LightingRev2PCB.kicad_pcb, Controls-LightingRev2PCB.kicad_sch, PolarityProtection_sch.kicad_sch]
2026-01-12 Changes from Review Request
    [Controls-LightingRev2PCB.kicad_pcb, Controls-LightingRev2PCB.kicad_sch, PolarityProtection_sch.kicad_sch]
2026-01-12 Layout complete and ready for review
    [Controls-LightingRev2PCB.kicad_pcb, Controls-LightingRev2PCB.kicad_sch, PolarityProtection_sch.kicad_sch]
2026-01-13 Hopefully Final Review
    [Controls-LightingRev2PCB.kicad_pcb]
2026-01-13 Adjusted test points for better gnd and power connection
    [Controls-LightingRev2PCB.kicad_pcb, PolarityProtection_sch.kicad_sch]
2026-01-13 Layout with 0 DRS and polarity errors
    [Controls-LightingRev2PCB.kicad_pcb, Controls-LightingRev2PCB.kicad_sch, PolarityProtection_sch.kicad_sch]
2026-01-14 Bom and Final Layout
    [Controls-LightingRev2PCB-B_Cu.gbr, Controls-LightingRev2PCB-B_Mask.gbr, Controls-LightingRev2PCB-B_Paste.gbr, Controls-LightingRev2PCB-B_Silkscreen.gbr, Controls-LightingRev2PCB-Edge_Cuts.gbr, Controls-LightingRev2PCB-F_Cu.gbr, Controls-LightingRev2PCB-F_Mask.gbr, Controls-LightingRev2PCB-F_Paste.gbr]
2026-01-14 Bom + Layout
    [Controls-LightingRev2PCB.kicad_pcb]
2026-03-15 add JLCPCB assembly files
    [Controls-LightingRev2PCB-CuBottom.gbr, Controls-LightingRev2PCB-CuTop.gbr, Controls-LightingRev2PCB-EdgeCuts.gbr, Controls-LightingRev2PCB-MaskBottom.gbr, Controls-LightingRev2PCB-MaskTop.gbr, Controls-LightingRev2PCB-NPTH.drl, Controls-LightingRev2PCB-PTH.drl, Controls-LightingRev2PCB-SilkBottom.gbr]
2026-03-15 move connectors a lil bit
    [Controls-LightingRev2PCB-CuBottom.gbr, Controls-LightingRev2PCB-CuTop.gbr, Controls-LightingRev2PCB-EdgeCuts.gbr, Controls-LightingRev2PCB-MaskBottom.gbr, Controls-LightingRev2PCB-MaskTop.gbr, Controls-LightingRev2PCB-NPTH.drl, Controls-LightingRev2PCB-PTH.drl, Controls-LightingRev2PCB-SilkBottom.gbr]
